Thijsva05/LineFollowingRobotThijs/images/PXL_20240106_170523985.PORTRAIT.jpg

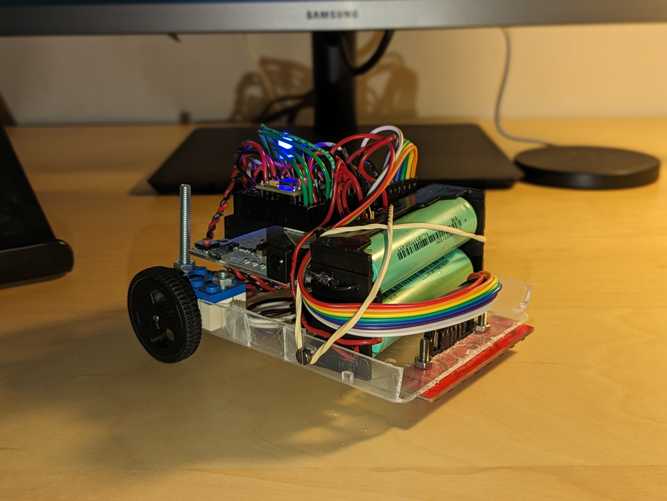
images/PXL_20240106_170523985.PORTRAIT.jpg
