Thijsva05/LineFollowingRobotThijs/images/PXL_20231225_115011983.jpg

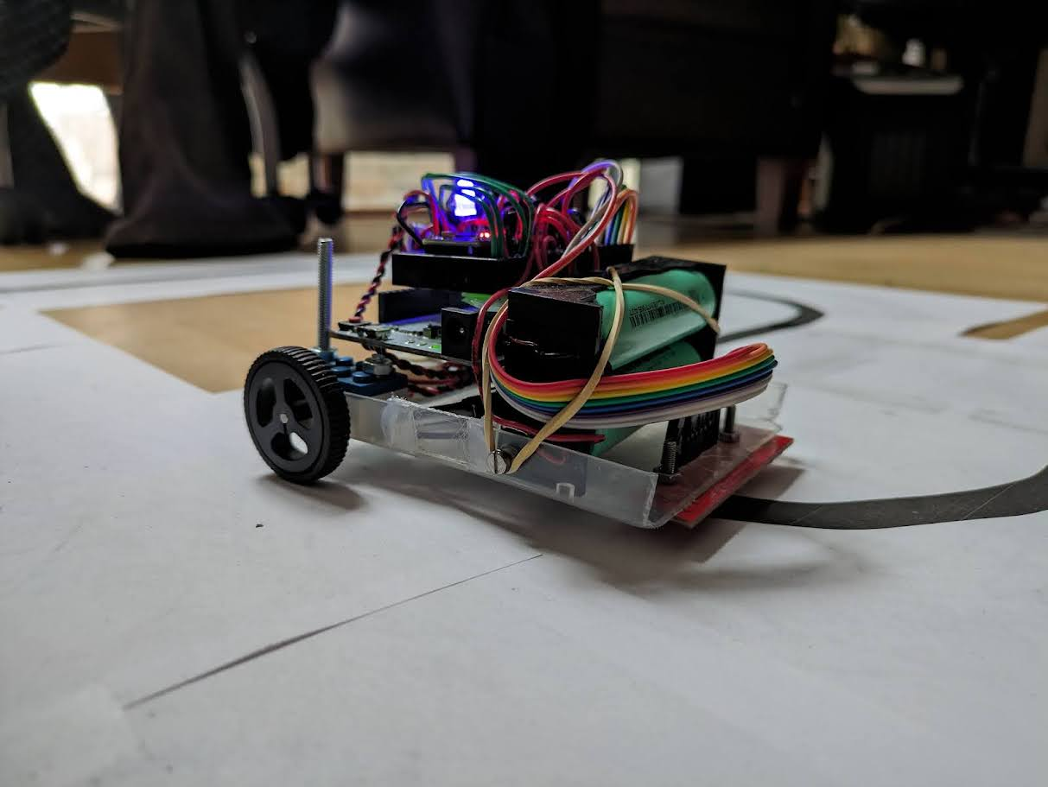
images/PXL_20231225_115011983.jpg
