Thijsva05/LineFollowingRobotThijs/readme.md

# LineFollower

PXL_20240106_170523985 PORTRAIT

## specifications

microcontroller: VMA 103 (Arduino Leonardo) ATMega32u4

motors: 600 RPM 6V

h-bridge: DRV8833

sensors: QTR-8A IR Line Following sensor

batteries: 18650 Li-ion 3100 mAh

wireless communication: HC-05 Bluetooth

distance sensor - motors: 90 mm

weight: 264 g

speed: 0,311 m/s
