Thijsva05/LineFollowingRobotThijs/code/proof of concepts/interrupt/E_schema.png

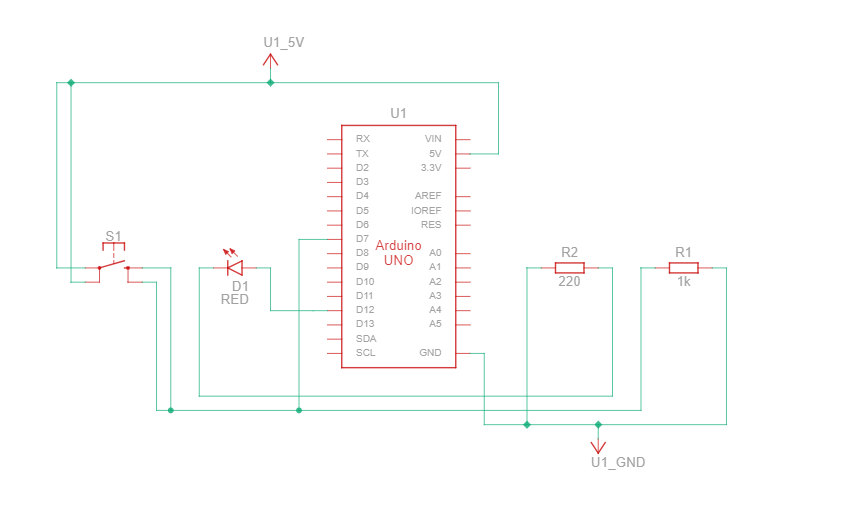
code/proof of concepts/interrupt/E_schema.png
