Thijsva05/LineFollowingRobotThijs/images/back cad.png

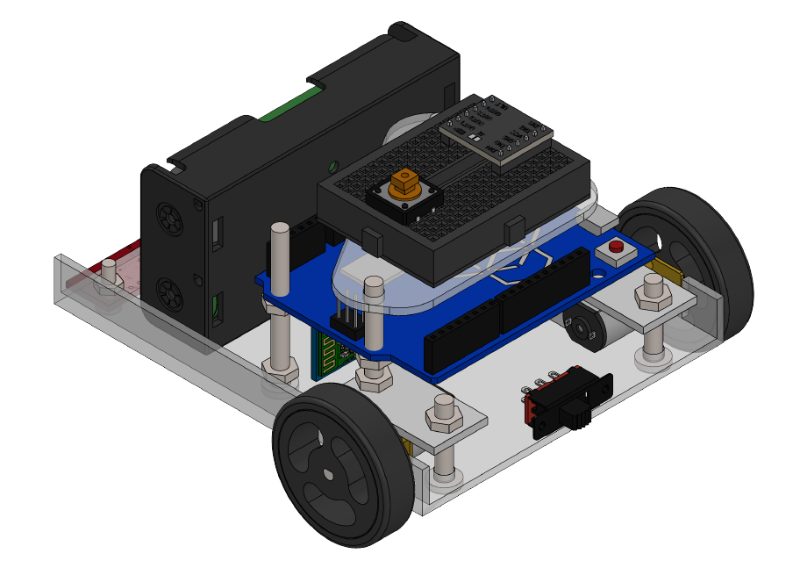
images/back cad.png
