Thijsva05/LineFollowingRobotThijs/images/Exploded_view.png

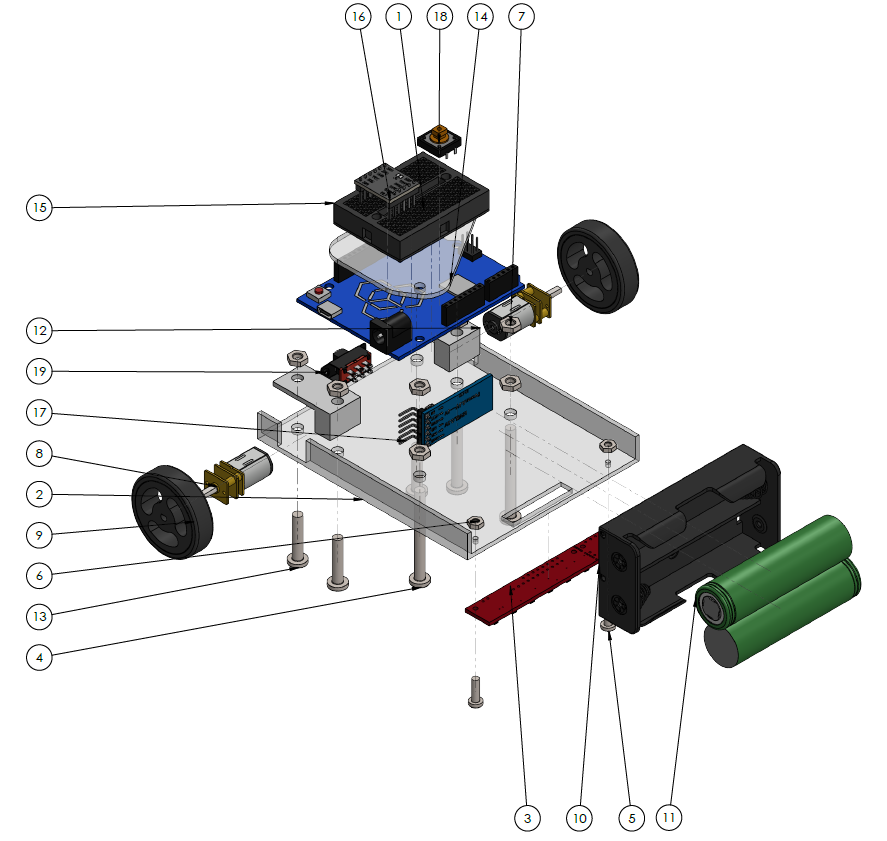
images/Exploded_view.png
