Thijsva05/LineFollowingRobotThijs/images/front cad.png

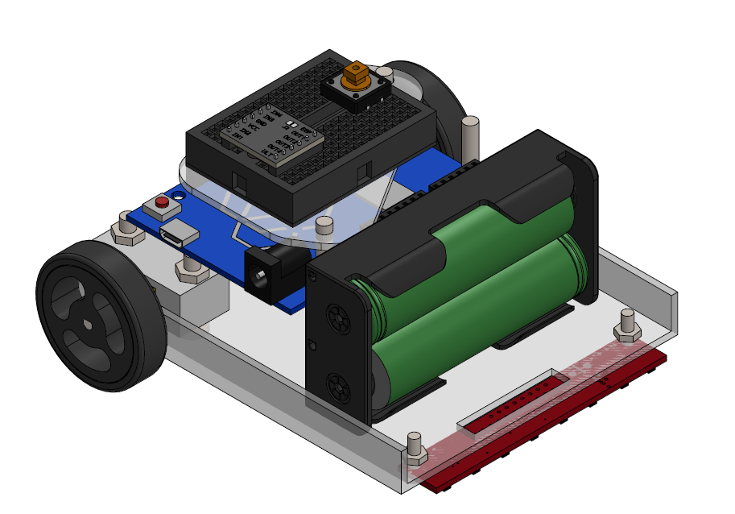
images/front cad.png
