Thijsva05/LineFollowingRobotThijs/technische tekeningen/elektronisch/PXL_20231215_160650324.jpg

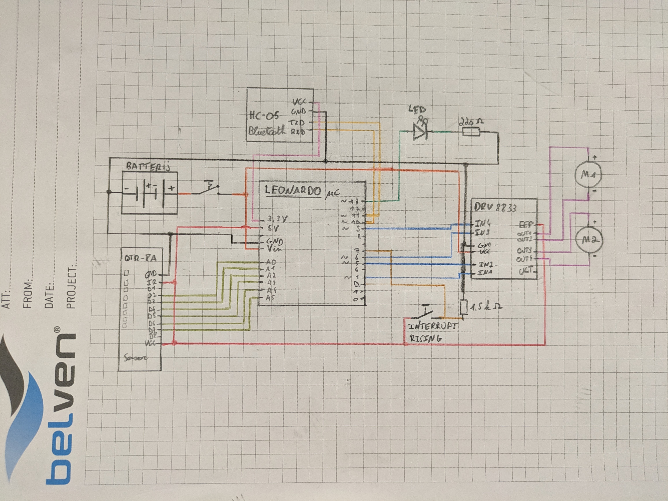
technische tekeningen/elektronisch/PXL_20231215_160650324.jpg
