Thijsva05/LineFollowingRobotThijs/bill of materials/readme.md

## bill of materials
<br />

|volgnummer|naam           |omschrijving                                                           |nieuw/recup|kostprijs/stuk|aantal|subtotaal|
|         1|IR Sensor      |8 Channel TCRT5000 IR Photoelectric Line Track Module QTR-8A           |nieuw      |€1,45         |1     |€1,45    |
|         2|Wieltjes       |ZJ327 3PI miniQ car N20 motor rubber wheel diameter 34mm code disc 34*7|nieuw      |€0,07         |2     |€0,14    |
|         3|H-brug         |DRV8833 2Channel DC Motor Driver Module Board 1.5A 3V-10V              |nieuw      |€0,34         |1     |€0,34    |
|         4|Batterij houder|ABS 18650 Power Bank Cases 2X 18650 Battery Holder Storage Box         |nieuw      |€0,93         |1     |€0,93    |
|         5|DC motor       |GA12-N20 DC 6V Micro Metal Gear Motor Gear Wheel Gear Motor 600 RPM    |nieuw      |€1,79         |2     |€3,58    |
|         6|Batterij lader |2 Slot 3.7V 18650 Charger Lii-PD4 USB Independent Charging             |nieuw      |€1,99         |1     |€1,99    |
|         7|Microcontroller|Velleman Arduino Leonardo Atmega32U4                                   |recup      |€0,00         |1     |€0,00    |
|         8|Batterij       |EVE 18650 Li-ion Batterij - 3100mAh - 10A - INR18650-33V               |nieuw      |€3,50         |2     |€7,00    |
|         9|Bluetooth      |HC-05 Bluetooth module                                                 |nieuw      |€2,49         |1     |€2,49    |
|        10|Oplader        |Battery Charger                                                        |nieuw      |€1,99         |1     |€1,99    |
                                                                                                                              |TOTAAL|€19,91   |
